garimamittal13/audio-amplifier/ewproject1.pdf

# Electronic Workshop - 2 :

# Project - 1

# Table Number : 37

## Garima Mittal - 2023102069

## Harshita Kumari - 2023102073

## International Institute of Information Technology

## Hyderabad

Electronic Workshop - 2 | Project - 1

## Contents

1 Introduction | 2
2 Pre-amplifier Circuit | 3
3 Common Emitter Configuration Amplifier | 5
4 Filter Design | 7
5 Power Amplifier | 9
6 Complete Circuit Results | 12
International Institute of Information Technology, Hyderabad | Page 1

## 1 Introduction

The project aims to design and build an audio amplifier consisting of four key stages: a pre-amplifier, a common emitter amplifier, a bandpass filter using an operational amplifier (op-amp), and a power amplifier. The goal is to create a system capable of amplifying audio signals, enabling both a microphone (mic) and a speaker to work effectively in audio applications.
The pre-amplifier stage boosts the low-level signal from the microphone to a level that can be processed by subsequent stages. The common emitter amplifier stage further amplifies the signal and provides necessary voltage gain. This stage is critical for improving the signal strength while maintaining fidelity. The bandpass filter, implemented using an op-amp, serves to filter out unwanted frequencies, ensuring that only the desired audio range passes through to the next stages. This stage enhances the quality of the audio by removing noise or irrelevant frequency components. Finally, the power amplifier stage drives the speaker, providing the required power for sound reproduction. This stage is responsible for ensuring the amplified signal can be heard clearly at an adequate volume level.
The combination of these stages ensures high-quality sound amplification, enabling seamless communication between the microphone and speaker.
International Institute of Information Technology, Hyderabad | Page 2

## 2 Pre-amplifier Circuit

The Pre-amplifier stage is required for initial amplification of audio signal. Ideally, the Input resistance should not be low as this will cause the amplifier to draw high current, which the microphone cannot supply, leading to ineffective operation of the amplifier.
For this reason, the Common-Emitter Differential amplifier can be used as it has a high Input and Output impedance, with good noise performance. If the noise performance of a Pre-amplifier is bad, the already weak signal could be completely overpowered by noise .
In summation, the Pre-amplifier’s main purpose is to provide initial amplification to the signal to send it to the gain stage, while also preventing noise from entering the system.

### 2.1 Design

It is build by using 2 Bipolar Junction Transistors(BJT) in Active Mode

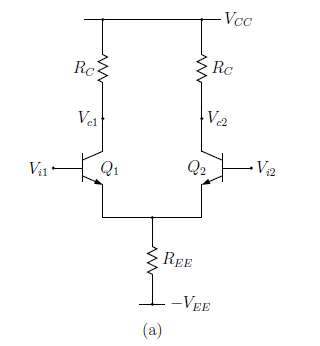
[picture p1: figure]

The Emitter currents from both Emitters of Bipolar Junction Transistors flow through Emitter Resistance REE.
Let’s do Small signal Analysis.
When Inputs are different then say Current across first BJT is Ie1, while that of second BJT is Ie2. By using V = IR for both internal emitter resistance re.

V1 − VE = Ie1 ∗ re

=⇒ Ie1 =

V1 − VE
re
V2 − VE = Ie2 ∗ re

=⇒ Ie2 =

V2 − VE
re
International Institute of Information Technology, Hyderabad | Page 3

Considering α close to 1. Then Collector current will be approximately equal to Emitter current . Then
Vc1 = RC

−(V1 − VE)
re

Vc2 = RC

−(V2 − VE)
re

=⇒ Vc1 − Vc2 = RC

V2 − V1
re

Gain =

RC
re

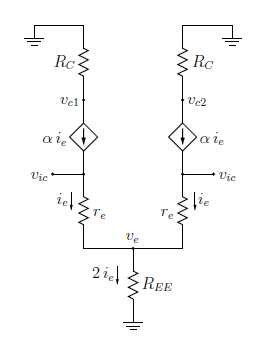
[picture p2: figure]

Let’s ground input of second BJT then gain of signal at collector of second BJT will be RC
2re

. We
know that
gm =

1
re

gm =

Ic

Vth
By choosing Gain and Collector resistance we can calculate re . From above relation we can calculate DC current IC .
For Second BJT to act in Active region we need VE greater than 0.7 . A current of 2*IC flows through Resistor REE.
Thus Pre amplifier is designed. Note Load of next stage must be considered as that will effect the gain to

Gain =

RC ||RL
2 ∗ re
International Institute of Information Technology, Hyderabad | Page 4

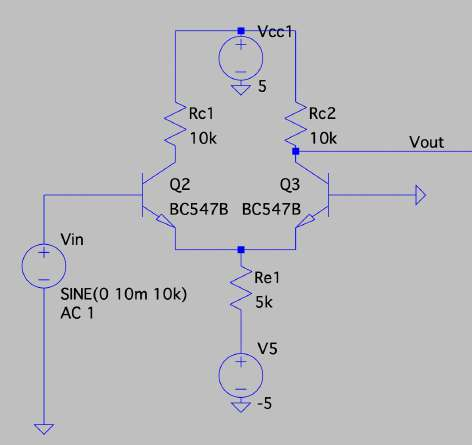
[picture p3: figure]

Figure 1: Differential Amplifier Circuit

## 3 Common Emitter Configuration Amplifier

The Amplifier is an electronic circuit that is used to increase the strength of a weak input signal in terms of voltage, current, or power. The process of increasing the strength of a weak signal is known as Amplification. One most important constraint during the amplification is that only the magnitude of the signal should increase and there should be no changes in the original signal shape. The Common Emitter Amplifier is a three basic single-stage bipolar junction transistor and is used as a voltage amplifier. The input of this amplifier is taken from the base terminal, the output is collected from the collector terminal and the emitter terminal is common for both the terminals.
When a signal is applied across the Emitter-Base Junction, the forward bias across this junction increases during the upper half cycle. This leads to an increase in the flow of electrons from the emitter to a collector through the base, hence increases the collector current. The increasing collector current makes more voltage drops across the collector load resistor RC.
The Negative Half cycle decreases the forward bias voltage across the emitter-base junction. The decreasing collector-base voltage decreases the collector current in the whole collector resistor RC. Thus, the amplified Load resistor appears across the collector resistor.
International Institute of Information Technology, Hyderabad | Page 5

AC Analysis

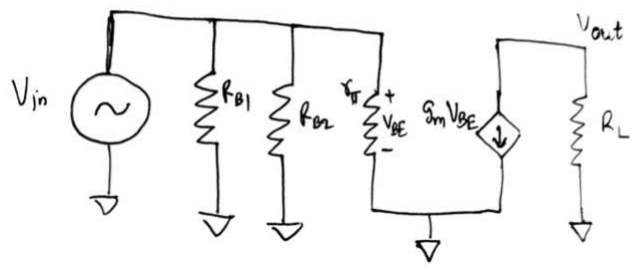
[picture p4: figure]

From the circuit, we have:

vBE = vin
ic = gm × vBE

∴ ic = gm × vin

vout = −ic × RL = −gm × vin × RL

∴ gain =

vout

vin

= −gm × RL

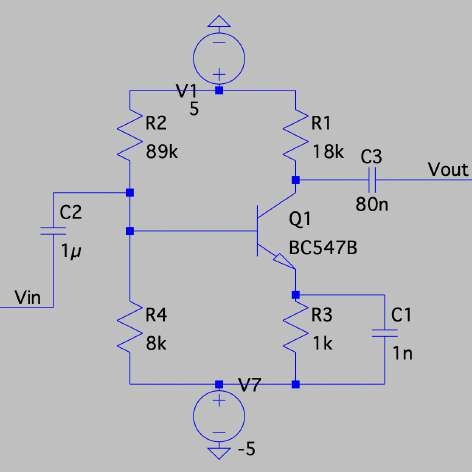
[picture p5: figure]

Figure 2: Common Emitter Amplifier Circuit

International Institute of Information Technology, Hyderabad | Page 6

## 4 Filter Design

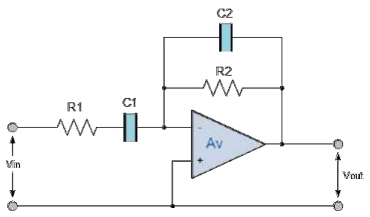
[picture p6: figure]

### 4.1 Circuit Description

The given circuit is an active band-pass filter that uses:

- A Resistor-Capacitor (RC) network for both low-pass and high-pass filtering.
- An operational amplifier (op-amp) to provide gain and buffering.

### 4.2 Working Principle

1. Input RC Network (High-Pass Filter): The first RC network at the input acts as a high-pass filter, blocking low-frequency components below its cutoff frequency (fL) and allowing higher frequencies to pass.
2. Feedback RC Network (Low-Pass Filter): The second RC network in the feedback loop acts as a low-pass filter, allowing frequencies below its cutoff frequency (fH) to pass while attenuating higher frequencies.
3. Band-Pass Filtering: The combination of the two RC networks results in a band-pass filter, allowing frequencies within the band (fL < f < fH) to pass while attenuating frequencies outside this range.

### 4.3 Circuit Analysis

The Non-Inverting terminal of operational amplifier is connected to ground. So due to virtual shorting , Inverting terminal is also virtual grounded.

Vin − 0 = I ∗ Z1

0 − Vout = I ∗ Z2

Gain = −

Z2
Z1

Z1 =

sR1C1 + 1
sC1

Z2 =

R2
sR2C2 + 1
International Institute of Information Technology, Hyderabad | Page 7

### 4.4 Transfer Function

The transfer function H(s), describing the frequency-dependent behavior, is given by:

H(s) = Vout

Vin

=

sR2C1
(sR1C1 + 1)(sR2C2 + 1)

where:

- s = jω (Laplace variable),
- R and C are the resistor and capacitor values.

### 4.5 Key Parameters

1. Center Frequency (f0):

f0 =

1
2π

√
R1R2C1C2

This is the frequency where the circuit achieves maximum gain.

2. Bandwidth (B):
BW = fH − fL

The range of frequencies passed by the filter.

3. Quality Factor (Q):

Q =

f0
B
A higher Q indicates a narrower pass band.
4. Cutoff Frequencies:
- Low cutoff frequency (fL):

fL =

1
2πR1C1
- High cutoff frequency (fH):

fH =

1
2πR2C2

### 4.6 Frequency Response

The frequency response of the circuit exhibits:

- Attenuation: For f < fL (low frequencies) and f > fH (high frequencies).
- Passband: Between fL and fH, centered at f0.
- A peak gain at f0, determined by the op-amp and feedback network configuration.
International Institute of Information Technology, Hyderabad | Page 8

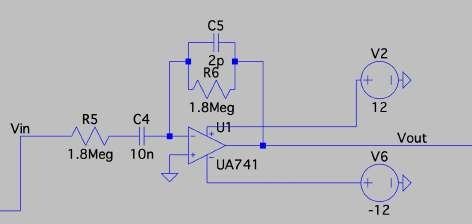
[picture p7: figure]

Figure 3: Filter Circuit

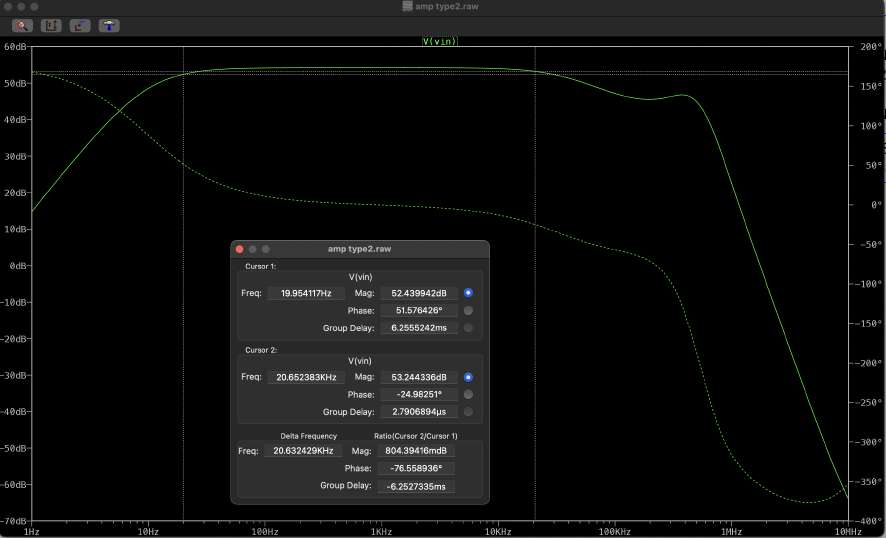
[picture p8: figure]

Figure 4: Filter Frequency Response

## 5 Power Amplifier

Power amplifiers are used to increase the power level of a signal and are commonly classified into Class-A, Class-B, and Class-AB based on their operating point, conduction angle, and efficiency.

International Institute of Information Technology, Hyderabad | Page 9

### 5.1 Class-A Power Amplifier

- Operating Principle: The transistor in a Class-A amplifier is biased so that it remains active (in the linear region) throughout the entire input signal cycle (360° conduction angle).
- Features:

– High linearity, making it suitable for low-distortion amplification.
– Poor efficiency, typically around 25% − 30%.

– High heat dissipation due to continuous current flow even without input signal.

### 5.2 Class-B Power Amplifier

- Operating Principle: The transistor is biased at cutoff, and each transistor in a push-pull configuration conducts for half of the input signal cycle (180° conduction angle).
- Features:

– Higher efficiency compared to Class-A, typically around 50% − 70%.

– Introduces crossover distortion due to the transition between transistors. – Requires a complementary pair of transistors (NPN and PNP or MOSFETs).

### 5.3 Class-AB Power Amplifier

- Operating Principle: Combines the features of Class-A and Class-B by biasing the transistors slightly above cutoff, allowing both transistors to conduct for slightly more than half of the signal cycle (greater than 180° but less than 360° conduction angle).
- Features:

– Improved linearity compared to Class-B, reducing crossover distortion. – Higher efficiency than Class-A, typically around 50%.

– Moderate heat dissipation, balancing efficiency and linearity.

International Institute of Information Technology, Hyderabad | Page 10

Circuit Explanatory and Theory

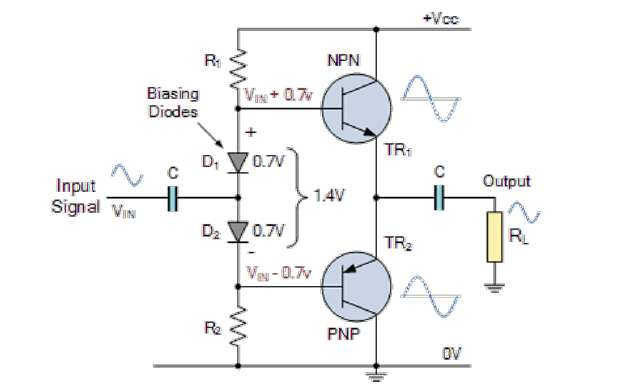
[picture p9: figure]

The amplifier uses two transistors: one NPN (top) and one PNP (bottom). During positive half-cycles of the input signal, the NPN transistor conducts, driving current into the load. During negative half-cycles, the PNP transistor conducts, sinking current from the load. Each transistor is biased so that it conducts for slightly more than 180° of the signal cycle. This small overlap in conduction prevents a dead zone at the zero-crossing point, thereby reducing crossover distortion that is typical of Class B amplifiers.
Two diodes D1 and D2 have forward voltage drops of 0.7V across them. They provide a small forward bias voltage between bases, keeping both transistors on verge of conduction even when input signal is absent or zero. When the input signal goes positive, the bias arrangement plus the input voltage makes the NPN transistor conduct more, while the PNP transistor is driven closer to cutoff (but not fully off). When the input goes negative, the roles reverse: the PNP transistor takes over conduction, while the NPN transistor is partially cut off. NPN handles the positive portion of the input waveform while PNP handles the negative portion of input waveform.
The emitters of both NPN and PNP transistors are connected. The speaker or output load is connected to this common emitter node. Resistor R1 and R2 are connected to bias between Vcc and VEE. R1 is equal to R2 so that when input is absent, voltage between the two diodes is zero. Also these resistors control the base current and provide stability.
The input and output coupling capacitor blocks DC component.
International Institute of Information Technology, Hyderabad | Page 11

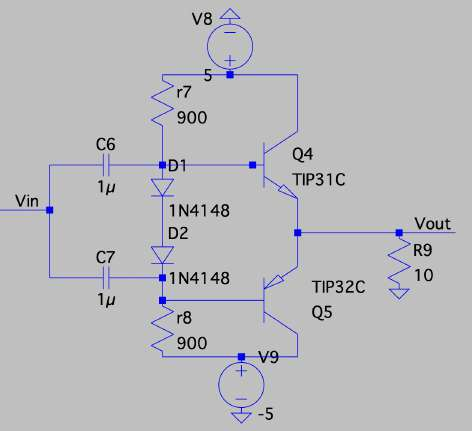
[picture p10: figure]

Figure 5: Power Amplifier Circuit

## 6 Complete Circuit Results

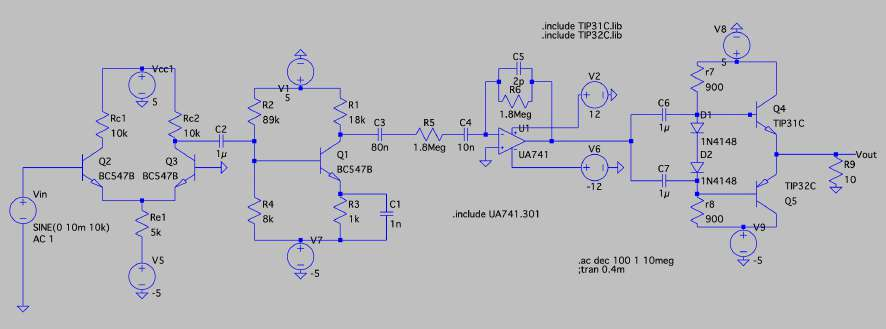
[picture p11: figure]

Figure 6: Full Circuit

International Institute of Information Technology, Hyderabad | Page 12

### 6.1 LT SPICE Results

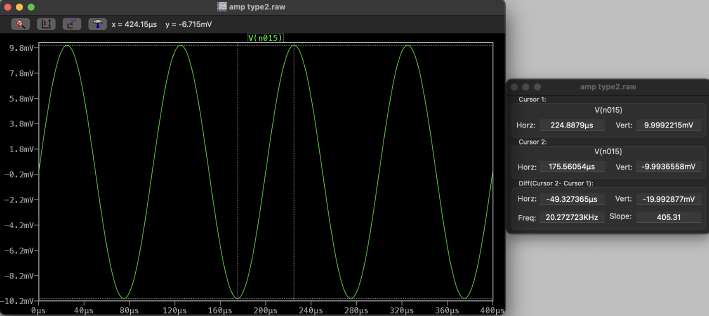
[picture p12: figure]

Figure 7: Input Signal

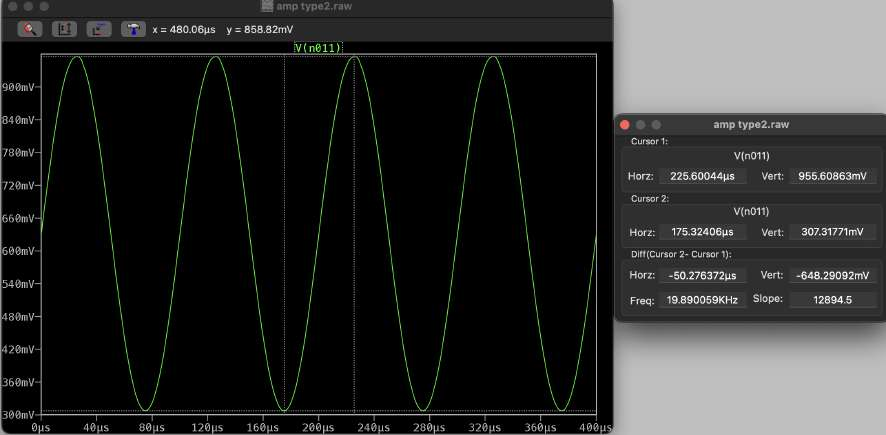
[picture p13: figure]

Figure 8: Differential Amplifier Output

International Institute of Information Technology, Hyderabad | Page 13

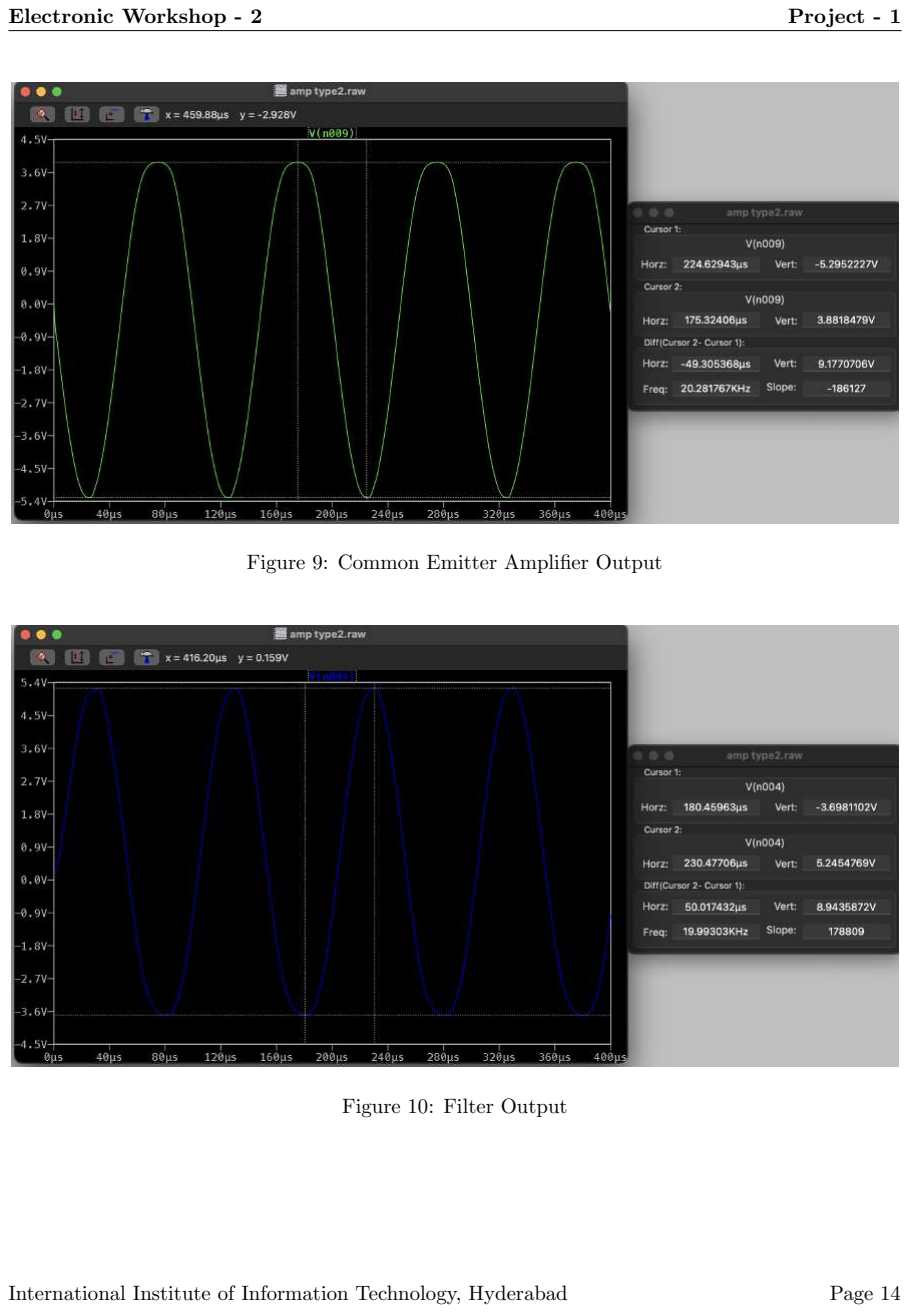
[picture p14: page 15]

Figure 9: Common Emitter Amplifier Output

Figure 10: Filter Output

International Institute of Information Technology, Hyderabad | Page 14

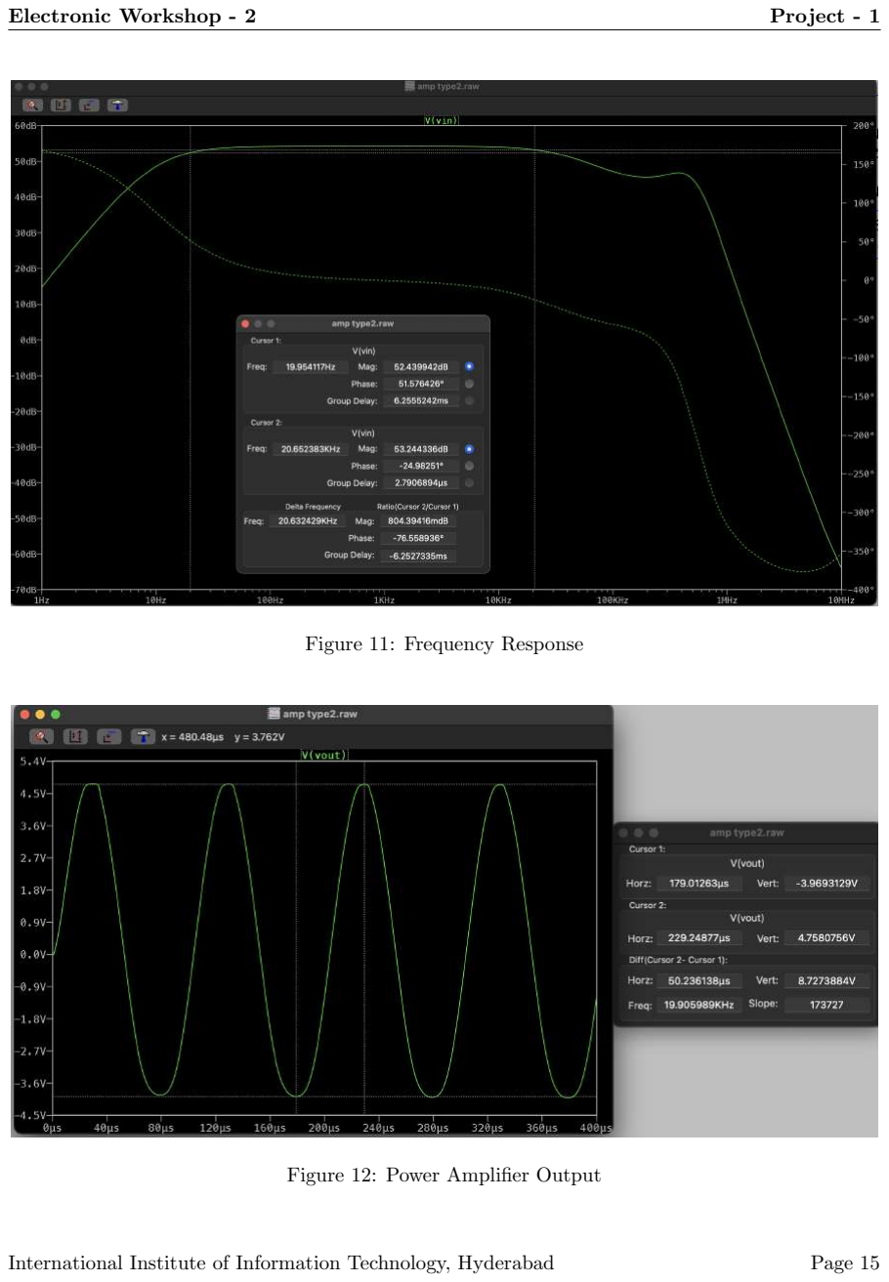
[picture p15: page 16]

Figure 11: Frequency Response

Figure 12: Power Amplifier Output

International Institute of Information Technology, Hyderabad | Page 15

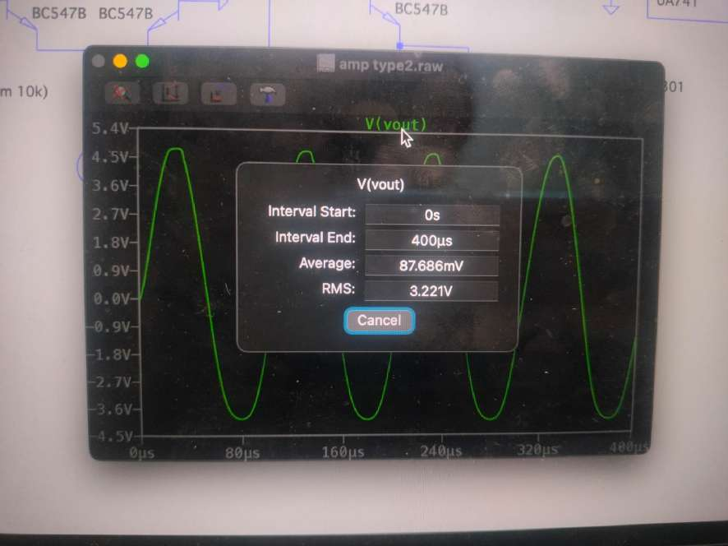
[picture p16: figure]

Figure 13: RMS Voltage

International Institute of Information Technology, Hyderabad | Page 16

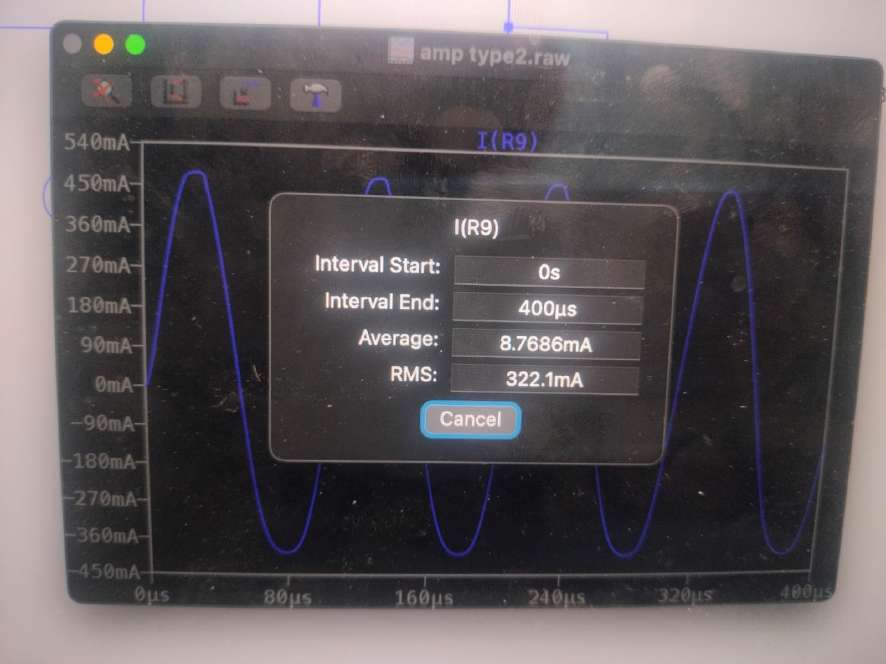
[picture p17: figure]

Figure 14: RMS current

International Institute of Information Technology, Hyderabad | Page 17

### 6.2 Circuit Results

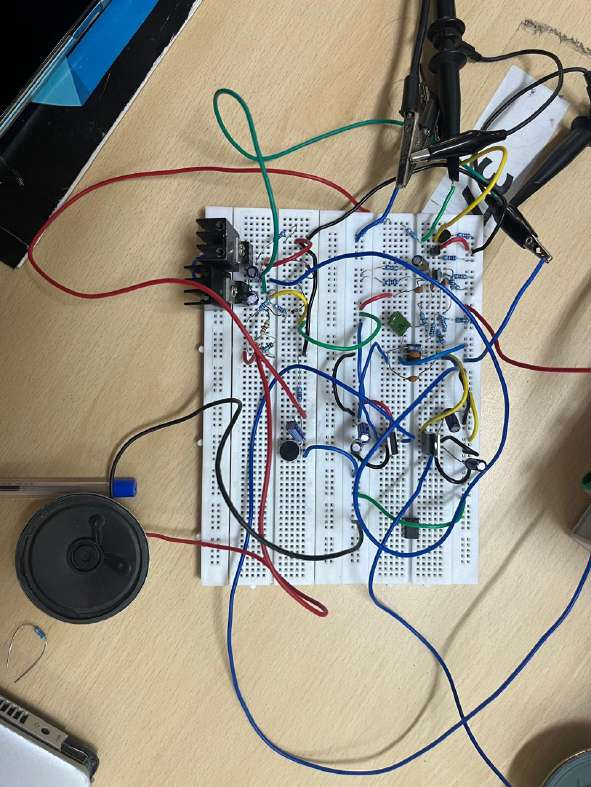
[picture p18: figure]

Figure 15: Full Circuit

International Institute of Information Technology, Hyderabad | Page 18

### 6.2.1 Differential Amplifier

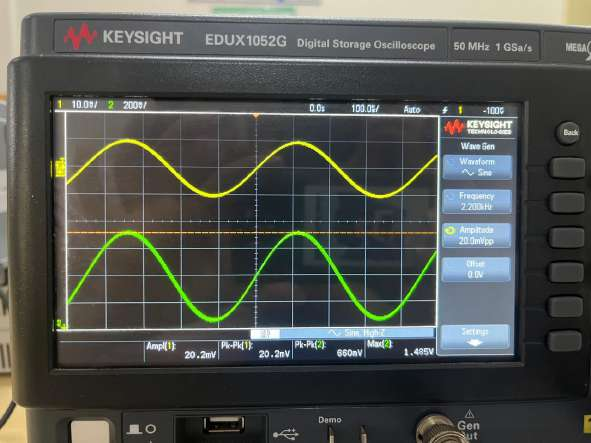
[picture p19: figure]

Figure 16: Differential Amplifier Output for 2.2kHz

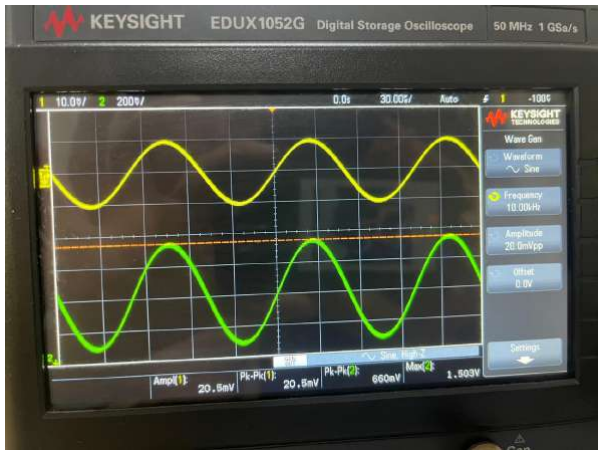
[picture p20: figure]

Figure 17: Differential Amplifier Output for 10kHz

International Institute of Information Technology, Hyderabad | Page 19

### 6.2.2 Common Emitter Amplifier

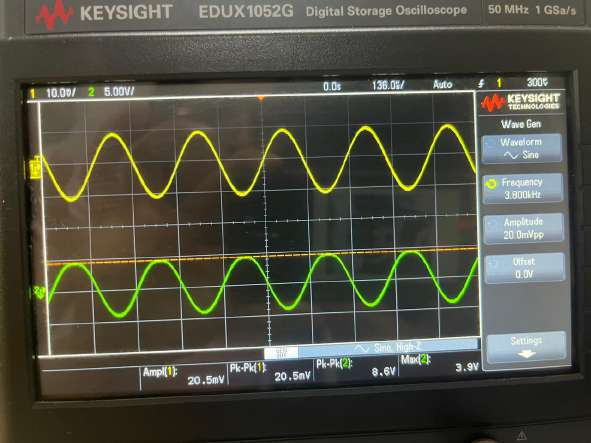
[picture p21: figure]

Figure 18: Common Emitter Amplifier Output for 3.8kHz

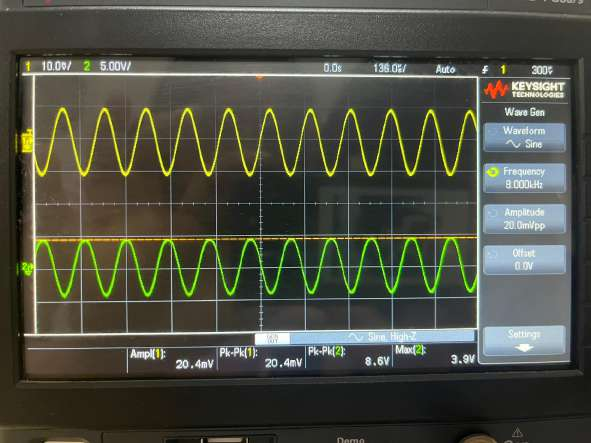
[picture p22: figure]

Figure 19: Common Emitter Amplifier Output for 8kHz

International Institute of Information Technology, Hyderabad | Page 20

### 6.2.3 Bandpass Filter

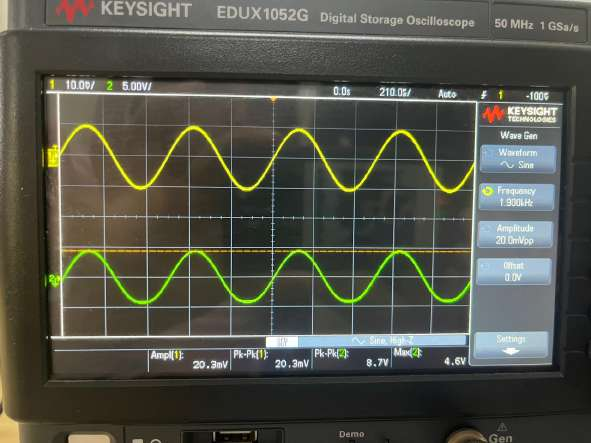
[picture p23: figure]

Figure 20: After Filter Output for 1.9kHz

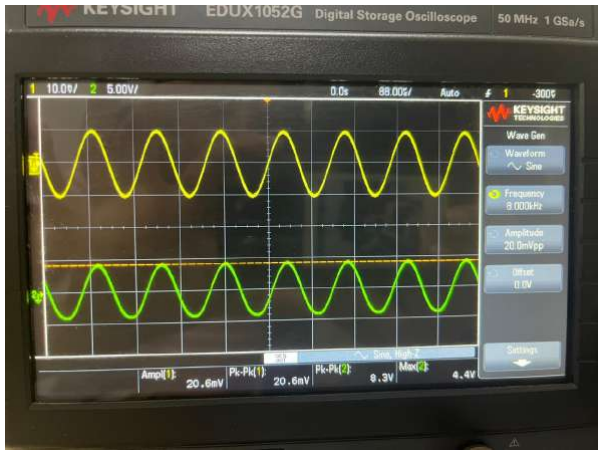
[picture p24: figure]

Figure 21: After Filter Output for 8kHz

International Institute of Information Technology, Hyderabad | Page 21

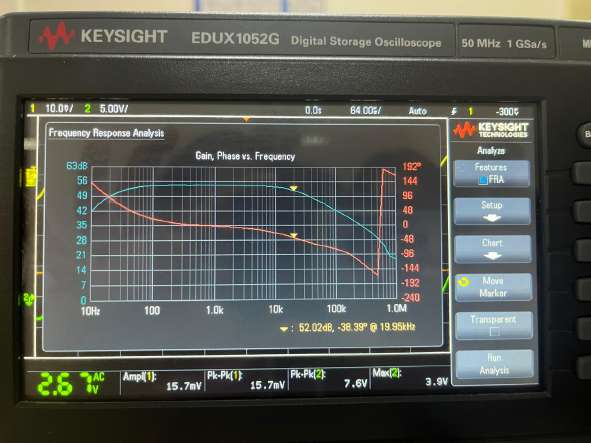
[picture p25: figure]

Figure 22: Frequency Response (Low pass Cutoff)

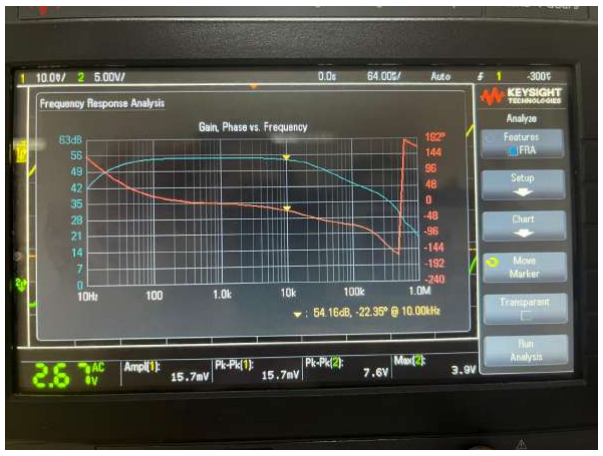
[picture p26: figure]

Figure 23: Frequency Response (For 10kHz)

International Institute of Information Technology, Hyderabad | Page 22

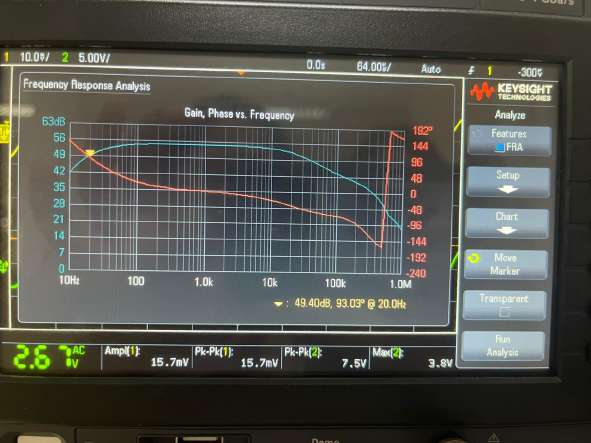
[picture p27: figure]

Figure 24: Frequency Response (High pass Cutoff)

### 6.2.4 Power Amplifier

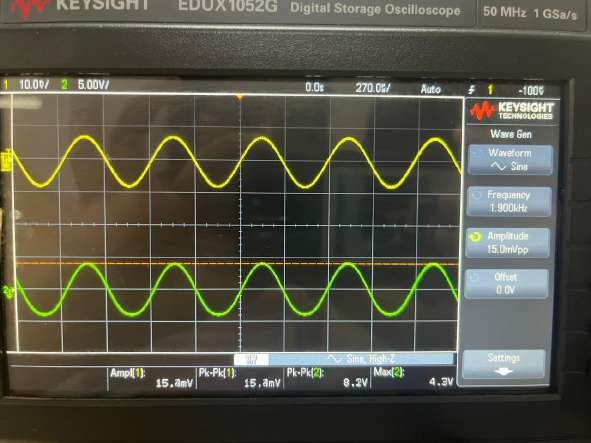
[picture p28: figure]

Figure 25: Power Amplifier for 1.9kHz

International Institute of Information Technology, Hyderabad | Page 23

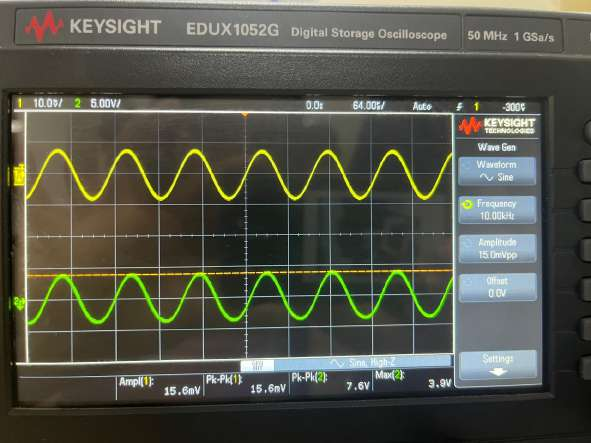
[picture p29: figure]

Figure 26: Power Amplifier for 10kHz

## Comparison Table

| Simulated Circuit | Physical Circuit
Only Pre-amp Gain | 32.4 | 33
After CE amp Gain | 460 | 415
Complete Circuit gain | 436 | 420
Flat Band Gain | 54dB | 54.1dB
3dB Bandwidth | 35KHz | 19.95KHz

## Problems Faced & Limitations

- Introduction of unwanted noise at every stage from the electrical components such as DSO and Wave-generator. Also thermal noise due to heating of resistors and ICs.
- Frequent heating of voltage divider ICs and MOSFETs led to inaccurate output and hence circuit breakdown.
- Power supply was limited to ±15V except for the filter stage, which caused obstruction in reaching higher gain as further increasing gain without increasing supply led to clipping of output.
International Institute of Information Technology, Hyderabad | Page 24
