garimamittal13/audio-amplifier/simulations/amp type1.asc

C1: cap; 800n
C2: cap; 150n
CE: cap; 1n
CF1: cap; 30n
CF2: cap; 30p
CP1: cap; 10µ
CP2: cap; 10µ
D1: diode; 1N4148
D2: diode; 1N4148
Q1: npn; BC547B
Q2: npn; BC547B
Q3: npn; BC547B
Q4: npn; TIP31C
Q5: pnp; TIP32C
R1: res; 125k
R2: res; 15.5k
R3: res; 800
R4: res; 800
RC1: res; 12k
RC2: res; 12k
RC3: res; 8k
RE1: res; 8.5k
RE2: res; 900
RF1: res; 265k
RF2: res; 265k
RL: res; 10
U1: opamp2; UA741
VCC1: voltage; 5
VCC2: voltage; 5
VCC3: voltage; 5
VCC4: voltage; 12
VEE1: voltage; -5
VEE2: voltage; -5
VEE3: voltage; -5
VEE4: voltage; -12
Vin1: voltage; SINE(0 10m 1k); AC 1
Vin2: voltage; SINE(0 -10m 1k); AC 1
Named nets: 0, mid
.include UA741.301
out
.include TIP31C.lib
.include TIP32C.lib
;ac dec 1000 1 100k
.tran 4m
