garimamittal13/audio-amplifier/simulations/amp type2.asc

C1: cap; 1n
C2: cap; 1µ
C3: cap; 80n
C4: cap; 10n
C5: cap; 2p
C6: cap; 1µ
C7: cap; 1µ
D1: diode; 1N4148
D2: diode; 1N4148
Q1: npn; BC547B
Q2: npn; BC547B
Q3: npn; BC547B
Q4: npn; TIP31C
Q5: pnp; TIP32C
R1: res; 18k
R2: res; 89k
R3: res; 1k
R4: res; 8k
R5: res; 1.8Meg
R6: res; 1.8Meg
r7: res; 900
r8: res; 900
R9: res; 10
Rc1: res; 10k
Rc2: res; 10k
Re1: res; 5k
U1: opamp2; UA741
V1: voltage; 5
V2: voltage; 12
V5: voltage; -5
V6: voltage; -12
V7: voltage; -5
V8: voltage; 5
V9: voltage; -5
Vcc1: voltage; 5
Vin: voltage; SINE(0 10m 10k); AC 1
Named nets: 0, Vout
.include UA741.301
.include TIP31C.lib
.include TIP32C.lib
.ac dec 100 1 10meg
;tran 0.4m
